76EHwan/pico_esp32-cam_ftdi/field_20260916_164957.png

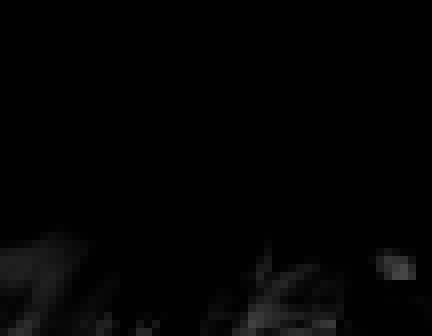
field_20260916_164957.png
