76EHwan/pico_esp32-cam_ftdi/(commit log)

2026-09-16 Add a posture stage on top of the 54x42 mask
    vision.c produces a clean mask; nothing yet says what the person in it is
    doing. This adds that as a host-side stage, so it needs no firmware change
    and runs against TYPE_MASK exactly as it is emitted today.
    mask -> geometry -> baseline-relative deviation -> label + phi/delta
    Labels are UPRIGHT / SLUMP / RECLINE / DROWSY / ABSENT. The two scalars are
    what a state machine downstream consumes; the label is for the operator.
    Two things drove the design.
    Head height cannot separate slumping from reclining. Both drop the head in
    the image - leaning back sinks it in frame exactly as folding forward does.
    So head height only measures how far from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
2026-09-16 Add a camera-only view
    viewer.py answers "is the pipeline doing the right thing" and carries a key for
    every stage to prove it. Framing, focus and exposure are a different question:
    they are settled at the camera, and no later stage can recover from getting
    them wrong - a covered lens and a blown-out frame both reach the mask as noise,
    and from there they are indistinguishable from a tuning problem.
    So this shows the 160x120 picture on its own, in grey rather than a colour map,
    with min/mean/max/spread underneath. Spread is the number that decides whether
    anything downstream can work at all.
    It turns the preview stream on at startup and off on the way out, and imports
    viewer.py's frame par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
    [camview.py]
2026-09-16 Make the sensor the only swappable part of the posture stage
    The first version rewrote the judgement around the mask, which forked it from
    the copy that is actually being run and tuned. Restructured so there is one
    judgement and the sensor is an adapter behind it.
    posture.py now takes a 54x42 array of distances and nothing else. Whatever
    produces that array is free to differ:
    esp_source.py bridge frames -> distances
    camera_source.py a webcam through the ESP32's and vision.c's stages
    (later) a real depth sensor, unchanged downstream
    Neither adapter has depth, so both estimate it from torso width - shoulders
    keep their width through a slump, so what moves them is distan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
    [camera_source.py, esp_source.py, palette.py, posture.py, posture_viewer.py, test_posture.py]
2026-09-17 Default the zone view on
    --zones was store_true, so the flag it added defaulted to off and the view
    started at the camera's own resolution - the opposite of what the flag was
    added for. Inverted to --no-zones, which leaves the default where the rest of
    the project sits.
    [thermal_pose.py]
2026-09-17 Put the zone grid on the cell boundaries
    sensor_grid takes one integer step and slices the image with it, which cannot
    describe the boundaries unless the display is a whole multiple of the cell
    count. It is not: 800 pixels over 54 cells is 14.81 each, a step of 14 has
    drifted three whole cells by the right-hand edge, and the last column falls off
    the picture.
    zone_grid computes each boundary instead. cv2.resize with INTER_NEAREST starts
    cell i at ceil(i*w/cols), so that is where the line goes - 15, 15, 15, 15, 15,
    14 across a 800 pixel row rather than a uniform 14. The division is done in
    integers: taking ceil of the float quotient lands a pixel late wherever it
    comes out whole, which is ev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
    [palette.py, thermal_pose.py]
2026-09-17 Hang arms off the tee
    Shoulder to elbow to wrist on each side, so the stick figure carries the joints
    that say what the arms are doing rather than only where the torso is.
    A hidden shoulder still drops the stem and that arm: with one shoulder the
    midpoint is unknown, and joining the head to the single visible shoulder would
    invent a chest that was never measured.
2026-09-17 Judge reclining, slumping and chin resting from the landmarks
    posture.py answers the same question from the 54x42 mask, which is everything a
    depth sensor gives. This reads named joints instead, so it can use the arms -
    and the arms are the whole of what makes a chin rest recognisable.
    Normalising by shoulder width is what makes one set of thresholds fit different
    people and sitting distances, and it has a consequence worth stating: it cancels
    distance. Move the whole person away and numerator and denominator shrink
    together, so leaning back does not register as "head down" the way it looks like
    it should. All that survives is the neck foreshortening as the torso tips,
    about a third of what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
2026-09-17 Recline on the shoulders alone
    Reclining also demanded a neck foreshortening, on the reasoning that shoulders
    narrowing by themselves is a chair pushed back rather than a posture. Against a
    real camera that was wrong twice.
    The sign was wrong: a camera below desk height looking up sees the neck
    lengthen as someone tips back, not shorten. And the size was beside the point -
    somebody lying back measured 0.19 of their reference shoulder width, which no
    chair has room for, while the neck term went the other way and vetoed it. The
    label never appeared.
    So reclining is the shoulders receding, full stop. A chair genuinely pushed
    straight back now reads as RECLINE; that is the better error, being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
    [posture_pose.py, test_posture_pose.py]
